pcduino/pcDuino3C_carrierboard/README.md

# pcDuino3C_carrierboard
This is the fully open source pcDuino3C carrierboard design files
