pcduino/pcDuino3C_carrierboard/pcDuino3c_carrierboard BOM.xlsx

Qty | Value | Device | Package | Parts
Connectors
1 | BTB-50PIN-0.8 | 50P socket | SMT | J3 J4 J5 J15
1 | 1x3P 2.54mm | single row header | plug | SV1
1 | 1X10P 2.54mm | single row socket | plug | JP4
1 | 1X6P 2.54mm | single row socket | plug | JP2
2 | 1X8P 2.54mm | single row socket | plug | JP1,JP3
1 | CON-BAT | CON-BAT | CON-BAT-5P-1MM | J1
1 | CON-HDMI | CON-HDMI | HDMI 19plug type A | J11
1 | CON-SATA | CON-SATA | CON-SATA | J13
1 | CON-USB | CON-USB | CON-USB | J7
1 | DCJ0202 | DCJ0202 | DCJ0202 | J2
1 | J1011F01P | network transformer | plug | X1 | unknown
1 | MINI-USB | USB socket | SMT | X2
5 | SMD_KEY | SMD_KEY | SMT | S1,S2,S3,S4,S5
1 | XH-2 2.54mm | XH-2 socket | plug | PWR
1 | FPC-30P-0.5 | FPC connector | FH12-30S-0.5SH | X3 | 1324555 | 34M6176
1 | SOCKET-MICROSD | SOCKET-MICROSD | SOCKET-MICROSD | J12
Resistors
2 | 0R | R-EU_R0402 | R0402 | R9,R21
1 | 0R | R-EU_R0805 | R0805 | R95
7 | 0R/NC | R-EU_R0402 | R0402 | R6,R80,R81,R82,R83,R85,R86,R36
4 | 100K | R-EU_R0402 | R0402 | R5,R29,R55,R87
1 | 100K/1% | R-EU_R0402 | R0402 | R1
1 | 100R | R-EU_R0402 | R0402 | R30,R34
5 | 100R/NC | R-EU_R0402 | R0402 | R66,R67,R68,R69,R70
29 | 10K | R-EU_R0402 | R0402 | R10,R12,R15,R17,R20,R24,R25,R26,R27,R28,R35,R37,R38,R39,R40,R41,R42,R54,R56,R57,R58,R59,R60,R61,R62,R71,R88,R90,R94
2 | 10k | R-EU_R0402 | R0402 | R43,R89
1 | 1K | R-EU_R0402 | R0402 | R8
5 | 2.2K | R-EU_R0402 | R0402 | R72,R73,R78,R79,R84
1 | 22K/1% | R-EU_R0402 | R0402 | R2
13 | 22R | R-EU_R0402 | R0402 | R46,R47,R48,R49,R50,R51,R52,R53,R63,R64,R91,R92,R93
1 | 33R | R-EU_R0402 | R0402 | R77
7 | 47K | R-EU_R0402 | R0402 | R3,R4,R7,R13,R19,R74,R75,R76
4 | 49.9R/1% | R-EU_R0402 | R0402 | R22,R23,R31,R32
2 | 510R | R-EU_R0402 | R0402 | R11,R45
1 | 6.2K/1% | R-EU_R0402 | R0402 | R33
2 | 4.7K | R-EU_R0402 | R0402 | R44,R65
Capacitor
27 | 100nF | C-EUC0402K | C0402 | C3,C5,C7,C12,C16,C18,C19,C21,C23,C24,C26,C28,C32,C33,C34,C35,C37,C39,C42,C44,C51,C56,C65,C66,C67,C68,C69
4 | 100nF | C-EUC0805 | C0805 | C9,C40,C49,C50
1 | 100pF | C-EUC0402K | C0402 | C48
4 | 10pF | C-EUC0402K | C0402 | C52,C53,C54,C55
1 | 10uF | C-EUC0402K | C0402 | C41
9 | 10uF | C-EUC0805 | C0805 | C2,C4,C6,C8,C22,C25,C27,C36,C38
2 | 18pF | C-EUC0402K | C0402 | C30,C31
4 | 1uF | C-EUC0402K | C0402 | C10,C14,C29,C45
3 | 1uF | C-EUC0805 | C0805 | C15,C17,C43
1 | 22nF | C-EUC0402K | C0402 | C13
1 | 22pF/NC | C-EUC0402K | C0402 | C46
1 | 22uF | C-EUC0805 | C0805 | C47
1 | 22uF/16V | C-EUC0805 | C0805 | C11
6 | 33pF | C-EUC0402K | C0402 | C57,C58,C59,C60,C61,C62
2 | 4.7uF | C-EUC0402K | C0402 | C63,C64
1 | 4.7uF | CPOL-EUCT7343 | CT7343 | C20
1 | 47pF | C-EUC0402K | C0402 | C1
Inductor, bead, crystal, fuse
1 | 2A_SMD | PTCFUSE-1206 | R1206 | F1
4 | 120R@300mA |  | R0603 | FB9,FB10,FB11,FB12,FB13
5 | 47R@500mA |  | R0603 | FB2,FB3,FB4,FB5,FB6
2 | LI0603EXXXR-10 | LI0603EXXXR-10 | R0603 | FB1,FB8
1 | 4.7uH/1.5A | INDICATORCD32 | CD32 | L1
3 | IND-CL-2M2012 | Inductor | CL-2M2012 | L2,L3,L4
1 | 25MHz | passive crystal | 3225 | Y1
1 | NC | LI0603EXXXR-10 | R0603 | FB7
Diode, transistor, MOS
1 | LED | LED-BLUE | LED-0805 | D6
1 | LED | LED-GREEN | LED-0805 | D2
2 | AO3401 | P-MOS | SOT23 | Q1,Q2
4 | MMBT3904 | NPN Transistor | SOT23 | T1,T2,T3,T4
1 | MMSZ5232B | DIODE-SMD2010 | D2010 | D5
2 | XBS104S14 | SCHOTTKY | D1206 | D7,D8
44 | ESDPSA0402V05 | ESDPSA0402V05 | R0402 | ESD1,ESD2,ESD3,ESD4,ESD5,ESD6,ESD7,ESD8,ESD9,ESD10,ESD11,ESD12,ESD13,ESD14,ESD15,ESD16,ESD17,ESD18,ESD19,ESD20,ESD21,ESD22,ESD23,ESD24,ESD25,ESD26,ESD27,ESD28,ESD29,ESD30,ESD31,ESD32,ESD33,ESD34,ESD35,ESD36,ESD37,ESD38,ESD39,ESD40,ESD41,ESD42,ESD43,ESD44
IC
1 | INFARED | INFARED | HS/VS1838 | U9
1 | IP101ALF | IP101ALF | LQFP48 | U4
1 | PJ-342B | PJ-342B | PJ-342B | J14
1 | AXK824145WG | CAM Male | 12x2P 0.4mm | J10
1 | RT9193GB | RT9193GB | SOT23-5 | U3
1 | RT9701GB | RT9701GB | SOT23-5 | U2
1 | RTL8188CUS | WIFI Mould | PCDUINO-WIFI-0_1PRIMARY | J8
3 | RCLAMP0524P | SEDFN05V4 | RCLAMP0524P | U6,U7,U8
1 | SY8088 | SY8088 | SOT23-5 | U1
