pcduino/pcDuino3C_carrierboard/pcDuino3c_carrierboard_designfiles/pcDuino3c_MB.brd

## EAGLE design pcDuino3c_carrierboard_designfiles/pcDuino3c_MB.brd (2015-03-08)

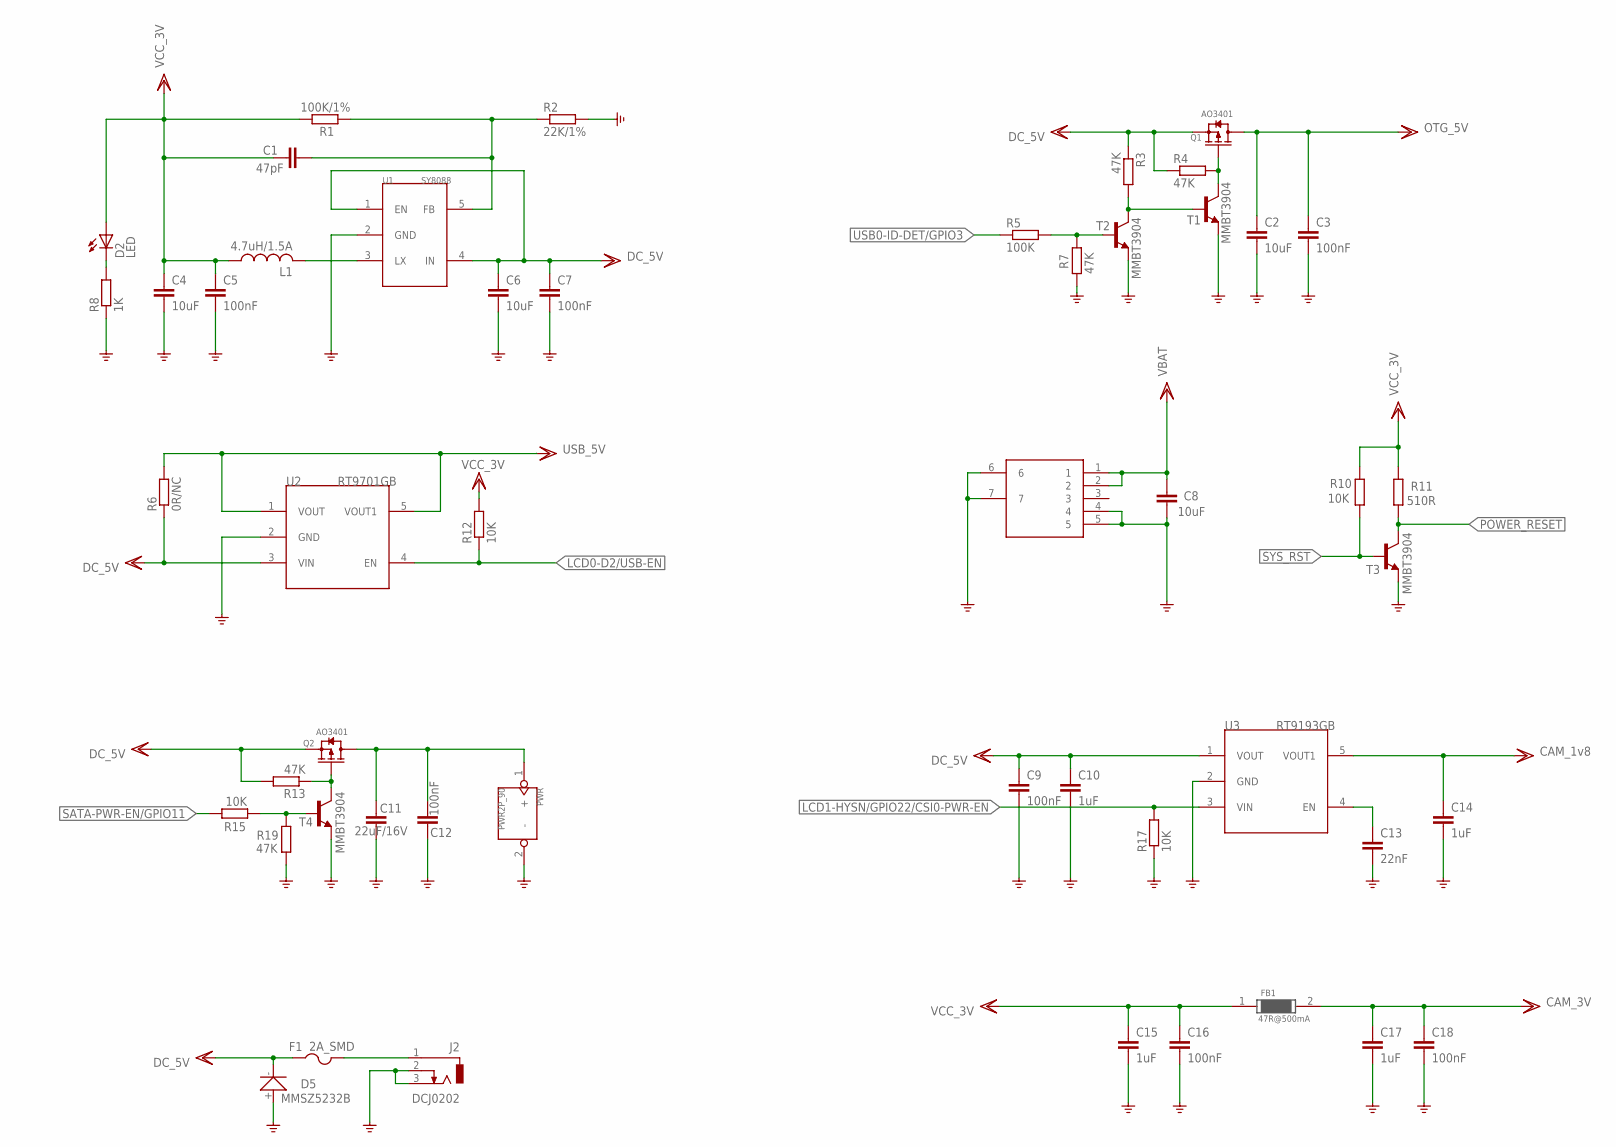
[picture p1: schematic pcDuino3c_MB.sch, sheet 1, PWR]

Parts:
C1: 47pF; C0402K
C2, C4, C6, C8: 10uF; C0805
C3, C5, C7, C12, C16, C18: 100nF; C0402K
C9: 100nF; C0805
C10, C14: 1uF; C0402K
C11: 22uF/16V; C0805
C13: 22nF; C0402K
C15, C17: 1uF; C0805
D2: LED; CHIP-LED-0805
D5: MMSZ5232B; SOD123
F1: 2A_SMD; R1206
FB1: 47R@500mA; R0603
J1: CON-BAT; CON-BAT-5P-1MM
J2: DCJ0202
L1: 4.7uH/1.5A; L_CD32
PWR: PWR2P_90; PWR2P_2.54
Q1, Q2: AO3401; SOT23
R1: 100K/1%; R0402
R2: 22K/1%; R0402
R3, R4, R7, R13, R19: 47K; R0402
R5: 100K; R0402
R6: 0R/NC; R0402
R8: 1K; R0402
R10, R12, R15, R17: 10K; R0402
R11: 510R; R0402
T1, T2, T3, T4: MMBT3904; SOT23-BEC
U1: SY8088; SOT23-5
U2: RT9701GB; SOT23-5
U3: RT9193GB; SOT23-5

Connections:
CAM_1V8: C14.1, U3.5 (VOUT1); also elsewhere on the board
CAM_3V: C17.1, C18.1, FB1.2; also elsewhere on the board
DC_5V: C6.1, C7.1, C9.1, C10.1, D5.-, F1.1, Q1.2 (S), Q2.2 (S), R3.1, R4.1, R6.1, R13.2, U1.1 (EN), U1.4 (IN), U2.3 (VIN), U3.1 (VOUT); also elsewhere on the board
GND: C2.2, C3.2, C4.2, C5.2, C6.2, C7.2, C8.2, C9.2, C10.2, C11.2, C12.2, C13.2, C14.2, C15.2, C16.2, C17.2, C18.2, D5.+, J1.4, J1.5, J1.6, J1.7, J2.2, J2.3, PWR.2 (-), R2.2, R7.1, R8.1, R17.1, R19.1, T1.E, T2.E, T3.E, T4.E, U1.2 (GND), U2.2 (GND), U3.2 (GND); also elsewhere on the board
LCD0-D2/USB-EN: R12.1, U2.4 (EN); also elsewhere on the board
LCD1-HYSN/GPIO22/CSI0-PWR-EN: R17.2, U3.3 (VIN)
unnamed: C13.1, U3.4 (EN)
unnamed: L1.2, U1.3 (LX)
unnamed: C1.2, R1.1, R2.1, U1.5 (FB)
unnamed: D2.C, R8.2
unnamed: Q1.1 (G), R4.2, T1.C
unnamed: R3.2, T1.B, T2.C
unnamed: R5.2, R7.2, T2.B
unnamed: C11.1, C12.1, PWR.1 (+), Q2.3 (D)
unnamed: F1.2, J2.1
unnamed: Q2.1 (G), R13.1, T4.C
unnamed: R15.1, R19.2, T4.B
OTG_5V: C2.1, C3.1, Q1.3 (D); also elsewhere on the board
POWER_RESET: R11.1, T3.C; also elsewhere on the board
SATA-PWR-EN/GPIO11: R15.2; also elsewhere on the board
SYS_RST: R10.1, T3.B; also elsewhere on the board
USB0-ID-DET/GPIO3: R5.1; also elsewhere on the board
USB_5V: R6.2, U2.1 (VOUT), U2.5 (VOUT1); also elsewhere on the board
VBAT: C8.1, J1.1, J1.2; also elsewhere on the board
VCC_3V: C1.1, C4.1, C5.1, C15.1, C16.1, D2.A, FB1.1, L1.1, R1.2, R10.2, R11.2, R12.2; also elsewhere on the board

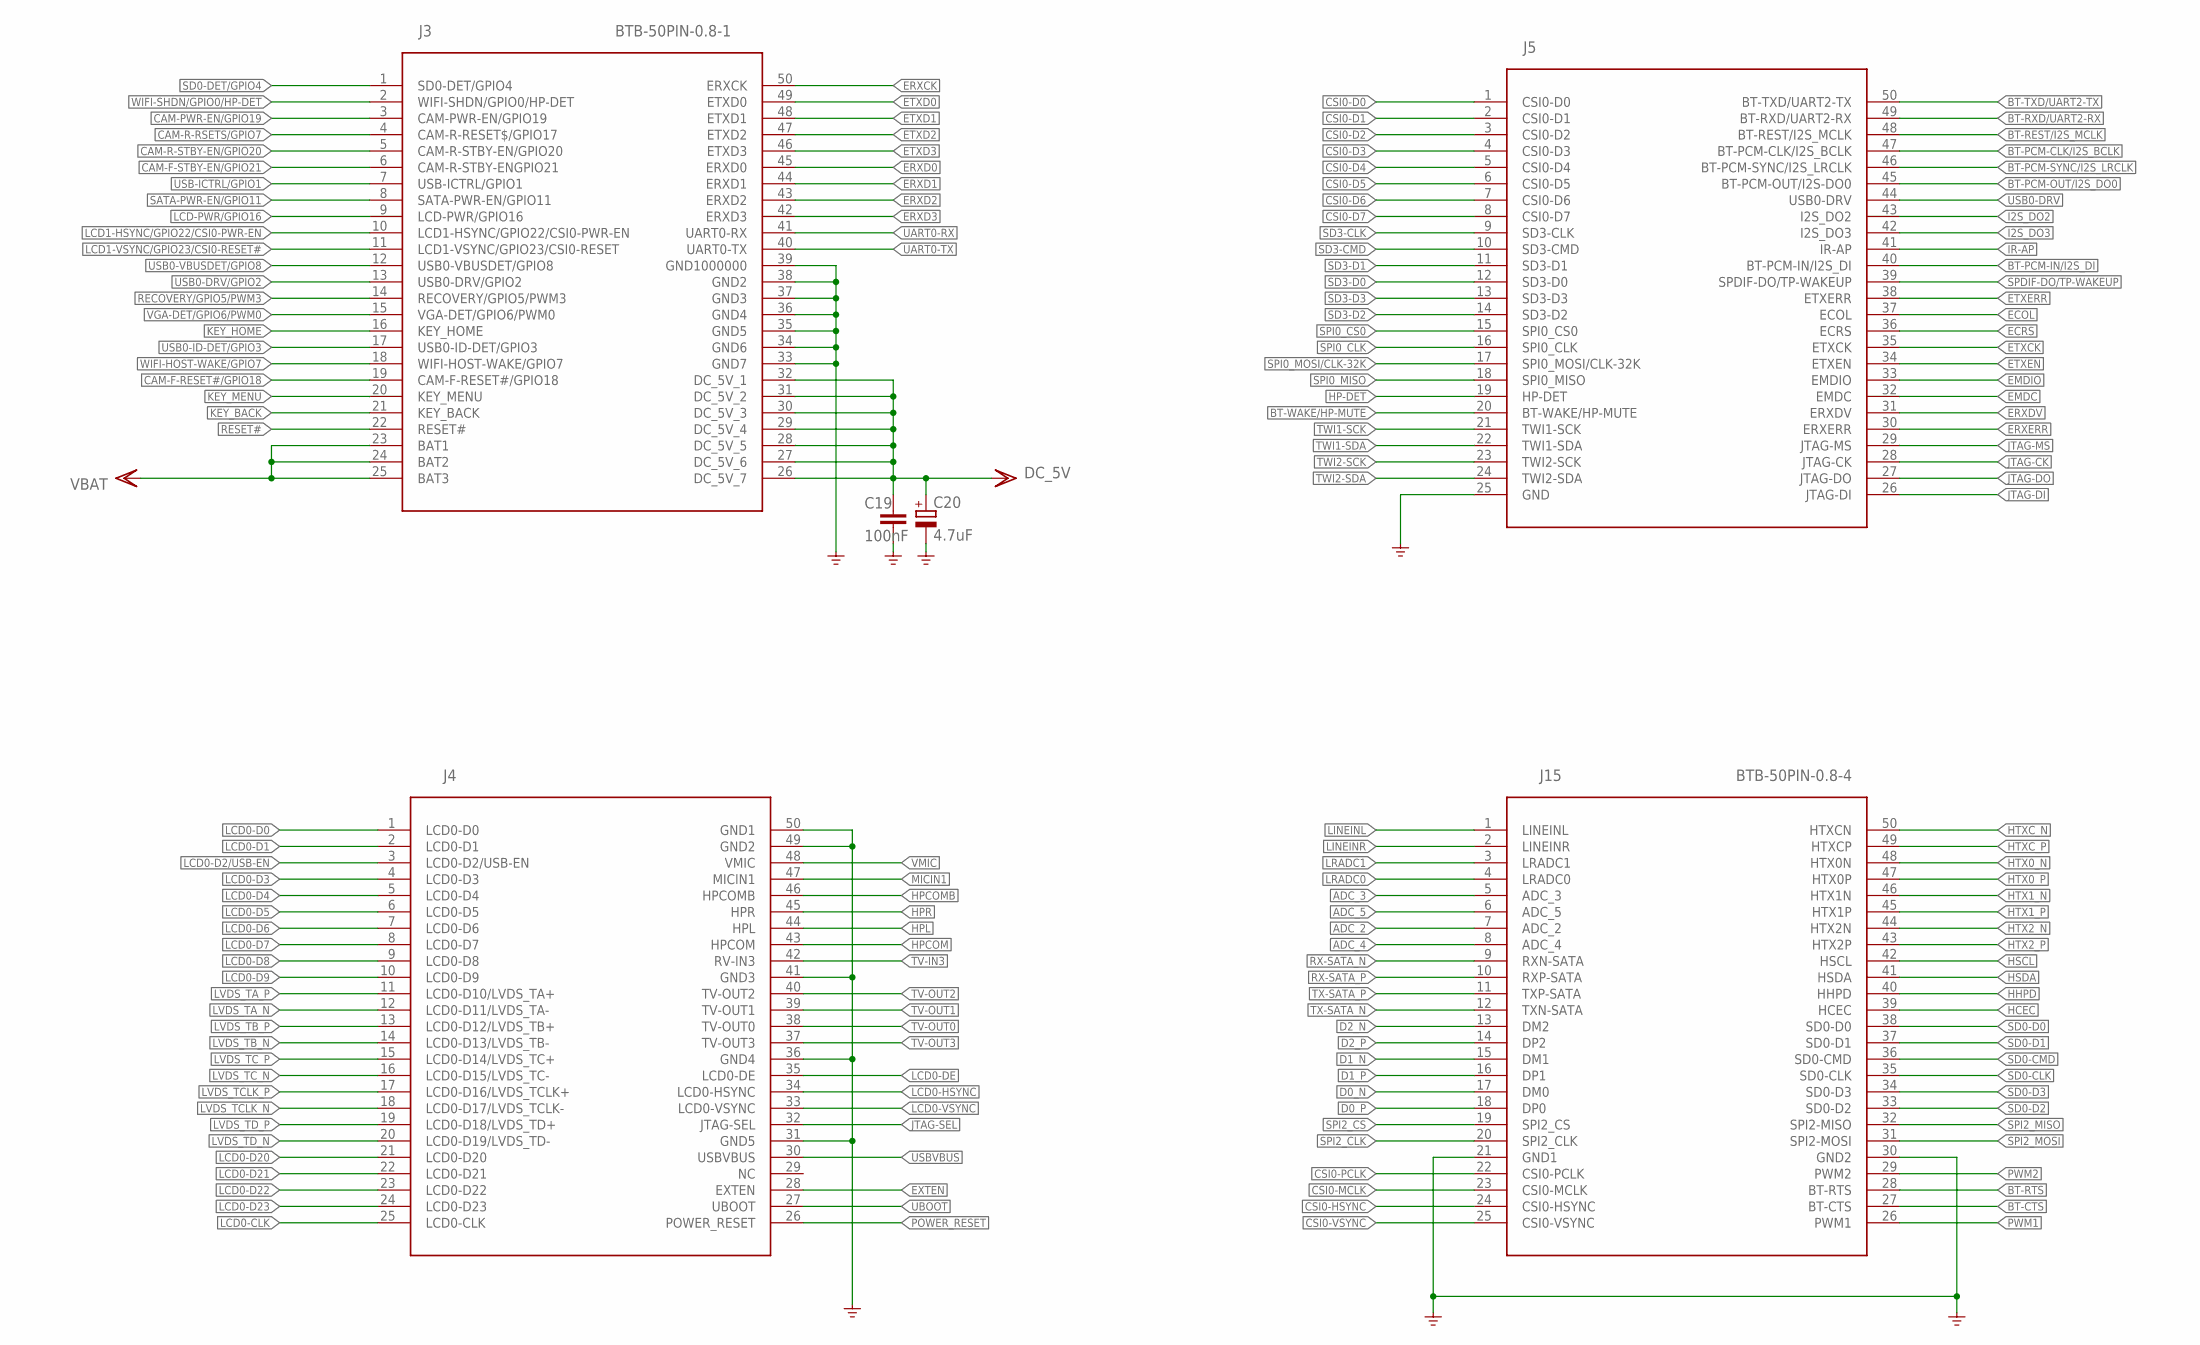
[picture p2: schematic pcDuino3c_MB.sch, sheet 2, A20 Core]

Parts:
C19: 100nF; C0402K
C20: 4.7uF; CT7343
J3: BTB-50PIN-0.8-1; BTB-50PIN-0.8
J4: BTB-50PIN-0.8-3; BTB-50PIN-0.8
J5: BTB-50PIN-0.8-2; BTB-50PIN-0.8
J15: BTB-50PIN-0.8-4; BTB-50PIN-0.8

Connections:
ADC_2: J15.7 (ADC_2); also elsewhere on the board
ADC_3: J15.5 (ADC_3); also elsewhere on the board
ADC_4: J15.8 (ADC_4); also elsewhere on the board
ADC_5: J15.6 (ADC_5); also elsewhere on the board
BT-CTS: J15.27 (BT-CTS)
BT-PCM-CLK/I2S_BCLK: J5.47 (BT-PCM-CLK/I2S_BCLK)
BT-PCM-IN/I2S_DI: J5.40 (BT-PCM-IN/I2S_DI)
BT-PCM-OUT/I2S_DO0: J5.45 (BT-PCM-OUT/I2S-DO0)
BT-PCM-SYNC/I2S_LRCLK: J5.46 (BT-PCM-SYNC/I2S_LRCLK)
BT-REST/I2S_MCLK: J5.48 (BT-REST/I2S_MCLK)
BT-RTS: J15.28 (BT-RTS)
BT-RXD/UART2-RX: J5.49 (BT-RXD/UART2-RX); also elsewhere on the board
BT-TXD/UART2-TX: J5.50 (BT-TXD/UART2-TX); also elsewhere on the board
BT-WAKE/HP-MUTE: J5.20 (BT-WAKE/HP-MUTE)
CAM-F-RESET#/GPIO18: J3.19 (CAM-F-RESET#/GPIO18); also elsewhere on the board
CAM-F-STBY-EN/GPIO21: J3.6 (CAM-R-STBY-ENGPIO21); also elsewhere on the board
CAM-PWR-EN/GPIO19: J3.3 (CAM-PWR-EN/GPIO19); also elsewhere on the board
CAM-R-RSETS/GPIO7: J3.4 (CAM-R-RESET$/GPIO17)
CAM-R-STBY-EN/GPIO20: J3.5 (CAM-R-STBY-EN/GPIO20); also elsewhere on the board
CSI0-D0: J5.1 (CSI0-D0); also elsewhere on the board
CSI0-D1: J5.2 (CSI0-D1); also elsewhere on the board
CSI0-D2: J5.3 (CSI0-D2); also elsewhere on the board
CSI0-D3: J5.4 (CSI0-D3); also elsewhere on the board
CSI0-D4: J5.5 (CSI0-D4); also elsewhere on the board
CSI0-D5: J5.6 (CSI0-D5); also elsewhere on the board
CSI0-D6: J5.7 (CSI0-D6); also elsewhere on the board
CSI0-D7: J5.8 (CSI0-D7); also elsewhere on the board
CSI0-HSYNC: J15.24 (CSI0-HSYNC); also elsewhere on the board
CSI0-MCLK: J15.23 (CSI0-MCLK); also elsewhere on the board
CSI0-PCLK: J15.22 (CSI0-PCLK); also elsewhere on the board
CSI0-VSYNC: J15.25 (CSI0-VSYNC); also elsewhere on the board
D0_N: J15.17 (DM0); also elsewhere on the board
D0_P: J15.18 (DP0); also elsewhere on the board
D1_N: J15.15 (DM1); also elsewhere on the board
D1_P: J15.16 (DP1); also elsewhere on the board
D2_N: J15.13 (DM2); also elsewhere on the board
D2_P: J15.14 (DP2); also elsewhere on the board
DC_5V: C19.1, C20.+, J3.26 (DC_5V_7), J3.27 (DC_5V_6), J3.28 (DC_5V_5), J3.29 (DC_5V_4), J3.30 (DC_5V_3), J3.31 (DC_5V_2), J3.32 (DC_5V_1); also elsewhere on the board
ECOL: J5.37 (ECOL); also elsewhere on the board
ECRS: J5.36 (ECRS); also elsewhere on the board
EMDC: J5.32 (EMDC); also elsewhere on the board
EMDIO: J5.33 (EMDIO); also elsewhere on the board
ERXCK: J3.50 (ERXCK); also elsewhere on the board
ERXD0: J3.45 (ERXD0); also elsewhere on the board
ERXD1: J3.44 (ERXD1); also elsewhere on the board
ERXD2: J3.43 (ERXD2); also elsewhere on the board
ERXD3: J3.42 (ERXD3); also elsewhere on the board
ERXDV: J5.31 (ERXDV); also elsewhere on the board
ERXERR: J5.30 (ERXERR); also elsewhere on the board
ETXCK: J5.35 (ETXCK); also elsewhere on the board
ETXD0: J3.49 (ETXD0); also elsewhere on the board
ETXD1: J3.48 (ETXD1); also elsewhere on the board
ETXD2: J3.47 (ETXD2); also elsewhere on the board
ETXD3: J3.46 (ETXD3); also elsewhere on the board
ETXEN: J5.34 (ETXEN); also elsewhere on the board
ETXERR: J5.38 (ETXERR); also elsewhere on the board
EXTEN: J4.28 (EXTEN)
GND: C19.2, C20.-, J3.33 (GND7), J3.34 (GND6), J3.35 (GND5), J3.36 (GND4), J3.37 (GND3), J3.38 (GND2), J3.39 (GND1000000), J4.31 (GND5), J4.36 (GND4), J4.41 (GND3), J4.49 (GND2), J4.50 (GND1), J5.25 (GND), J15.21 (GND1), J15.30 (GND2); also elsewhere on the board
HCEC: J15.39 (HCEC); also elsewhere on the board
HHPD: J15.40 (HHPD); also elsewhere on the board
HP-DET: J5.19 (HP-DET)
HPCOM: J4.43 (HPCOM); also elsewhere on the board
HPCOMB: J4.46 (HPCOMB); also elsewhere on the board
HPL: J4.44 (HPL); also elsewhere on the board
HPR: J4.45 (HPR); also elsewhere on the board
HSCL: J15.42 (HSCL); also elsewhere on the board
HSDA: J15.41 (HSDA); also elsewhere on the board
HTX0_N: J15.48 (HTX0N); also elsewhere on the board
HTX0_P: J15.47 (HTX0P); also elsewhere on the board
HTX1_N: J15.46 (HTX1N); also elsewhere on the board
HTX1_P: J15.45 (HTX1P); also elsewhere on the board
HTX2_N: J15.44 (HTX2N); also elsewhere on the board
HTX2_P: J15.43 (HTX2P); also elsewhere on the board
HTXC_N: J15.50 (HTXCN); also elsewhere on the board
HTXC_P: J15.49 (HTXCP); also elsewhere on the board
I2S_DO2: J5.43 (I2S_DO2)
I2S_DO3: J5.42 (I2S_DO3)
IR-AP: J5.41 (IR-AP); also elsewhere on the board
JTAG-CK: J5.28 (JTAG-CK)
JTAG-DI: J5.26 (JTAG-DI)
JTAG-DO: J5.27 (JTAG-DO)
JTAG-MS: J5.29 (JTAG-MS)
JTAG-SEL: J4.32 (JTAG-SEL)
KEY_BACK: J3.21 (KEY_BACK); also elsewhere on the board
KEY_HOME: J3.16 (KEY_HOME); also elsewhere on the board
KEY_MENU: J3.20 (KEY_MENU); also elsewhere on the board
LCD0-CLK: J4.25 (LCD0-CLK)
LCD0-D0: J4.1 (LCD0-D0)
LCD0-D1: J4.2 (LCD0-D1)
LCD0-D2/USB-EN: J4.3 (LCD0-D2/USB-EN); also elsewhere on the board
LCD0-D3: J4.4 (LCD0-D3)
LCD0-D4: J4.5 (LCD0-D4)
LCD0-D5: J4.6 (LCD0-D5)
LCD0-D6: J4.7 (LCD0-D6)
LCD0-D7: J4.8 (LCD0-D7)
LCD0-D8: J4.9 (LCD0-D8)
LCD0-D9: J4.10 (LCD0-D9)
LCD0-D20: J4.21 (LCD0-D20)
LCD0-D21: J4.22 (LCD0-D21)
LCD0-D22: J4.23 (LCD0-D22)
LCD0-D23: J4.24 (LCD0-D23)
LCD0-DE: J4.35 (LCD0-DE)
LCD0-HSYNC: J4.34 (LCD0-HSYNC)
LCD0-VSYNC: J4.33 (LCD0-VSYNC)
LCD1-HSYNC/GPIO22/CSI0-PWR-EN: J3.10 (LCD1-HSYNC/GPIO22/CSI0-PWR-EN); also elsewhere on the board
LCD1-VSYNC/GPIO23/CSI0-RESET#: J3.11 (LCD1-VSYNC/GPIO23/CSI0-RESET); also elsewhere on the board
LCD-PWR/GPIO16: J3.9 (LCD-PWR/GPIO16)
LINEINL: J15.1 (LINEINL)
LINEINR: J15.2 (LINEINR)
LRADC0: J15.4 (LRADC0); also elsewhere on the board
LRADC1: J15.3 (LRADC1); also elsewhere on the board
LVDS_TA_N: J4.12 (LCD0-D11/LVDS_TA-); also elsewhere on the board
LVDS_TA_P: J4.11 (LCD0-D10/LVDS_TA+); also elsewhere on the board
LVDS_TB_N: J4.14 (LCD0-D13/LVDS_TB-); also elsewhere on the board
LVDS_TB_P: J4.13 (LCD0-D12/LVDS_TB+); also elsewhere on the board
LVDS_TCLK_N: J4.18 (LCD0-D17/LVDS_TCLK-); also elsewhere on the board
LVDS_TCLK_P: J4.17 (LCD0-D16/LVDS_TCLK+); also elsewhere on the board
LVDS_TC_N: J4.16 (LCD0-D15/LVDS_TC-); also elsewhere on the board
LVDS_TC_P: J4.15 (LCD0-D14/LVDS_TC+); also elsewhere on the board
LVDS_TD_N: J4.20 (LCD0-D19/LVDS_TD-); also elsewhere on the board
LVDS_TD_P: J4.19 (LCD0-D18/LVDS_TD+); also elsewhere on the board
MICIN1: J4.47 (MICIN1); also elsewhere on the board
POWER_RESET: J4.26 (POWER_RESET); also elsewhere on the board
PWM1: J15.26 (PWM1); also elsewhere on the board
PWM2: J15.29 (PWM2); also elsewhere on the board
RECOVERY/GPIO5/PWM3: J3.14 (RECOVERY/GPIO5/PWM3); also elsewhere on the board
RESET#: J3.22 (RESET#)
RX-SATA_N: J15.9 (RXN-SATA); also elsewhere on the board
RX-SATA_P: J15.10 (RXP-SATA); also elsewhere on the board
SATA-PWR-EN/GPIO11: J3.8 (SATA-PWR-EN/GPIO11); also elsewhere on the board
SD0-CLK: J15.35 (SD0-CLK); also elsewhere on the board
SD0-CMD: J15.36 (SD0-CMD); also elsewhere on the board
SD0-D0: J15.38 (SD0-D0); also elsewhere on the board
SD0-D1: J15.37 (SD0-D1); also elsewhere on the board
SD0-D2: J15.33 (SD0-D2); also elsewhere on the board
SD0-D3: J15.34 (SD0-D3); also elsewhere on the board
SD0-DET/GPIO4: J3.1 (SD0-DET/GPIO4); also elsewhere on the board
SD3-CLK: J5.9 (SD3-CLK)
SD3-CMD: J5.10 (SD3-CMD)
SD3-D0: J5.12 (SD3-D0)
SD3-D1: J5.11 (SD3-D1)
SD3-D2: J5.14 (SD3-D2)
SD3-D3: J5.13 (SD3-D3)
SPDIF-DO/TP-WAKEUP: J5.39 (SPDIF-DO/TP-WAKEUP)
SPI0_CLK: J5.16 (SPI0_CLK); also elsewhere on the board
SPI0_CS0: J5.15 (SPI0_CS0); also elsewhere on the board
SPI0_MISO: J5.18 (SPI0_MISO); also elsewhere on the board
SPI0_MOSI/CLK-32K: J5.17 (SPI0_MOSI/CLK-32K); also elsewhere on the board
SPI2_CLK: J15.20 (SPI2_CLK)
SPI2_CS: J15.19 (SPI2_CS)
SPI2_MISO: J15.32 (SPI2-MISO)
SPI2_MOSI: J15.31 (SPI2-MOSI)
TV-IN3: J4.42 (RV-IN3)
TV-OUT0: J4.38 (TV-OUT0)
TV-OUT1: J4.39 (TV-OUT1)
TV-OUT2: J4.40 (TV-OUT2)
TV-OUT3: J4.37 (TV-OUT3)
TWI1-SCK: J5.21 (TWI1-SCK); also elsewhere on the board
TWI1-SDA: J5.22 (TWI1-SDA); also elsewhere on the board
TWI2-SCK: J5.23 (TWI2-SCK); also elsewhere on the board
TWI2-SDA: J5.24 (TWI2-SDA); also elsewhere on the board
TX-SATA_N: J15.12 (TXN-SATA); also elsewhere on the board
TX-SATA_P: J15.11 (TXP-SATA); also elsewhere on the board
UART0-RX: J3.41 (UART0-RX); also elsewhere on the board
UART0-TX: J3.40 (UART0-TX); also elsewhere on the board
UBOOT: J4.27 (UBOOT); also elsewhere on the board
USB0-DRV: J5.44 (USB0-DRV)
USB0-DRV/GPIO2: J3.13 (USB0-DRV/GPIO2); also elsewhere on the board
USB0-ID-DET/GPIO3: J3.17 (USB0-ID-DET/GPIO3); also elsewhere on the board
USB0-VBUSDET/GPIO8: J3.12 (USB0-VBUSDET/GPIO8); also elsewhere on the board
USB-ICTRL/GPIO1: J3.7 (USB-ICTRL/GPIO1); also elsewhere on the board
USBVBUS: J4.30 (USBVBUS)
VBAT: J3.23 (BAT1), J3.24 (BAT2), J3.25 (BAT3); also elsewhere on the board
VGA-DET/GPIO6/PWM0: J3.15 (VGA-DET/GPIO6/PWM0); also elsewhere on the board
VMIC: J4.48 (VMIC); also elsewhere on the board
WIFI-HOST-WAKE/GPIO7: J3.18 (WIFI-HOST-WAKE/GPIO7); also elsewhere on the board
WIFI-SHDN/GPIO0/HP-DET: J3.2 (WIFI-SHDN/GPIO0/HP-DET); also elsewhere on the board

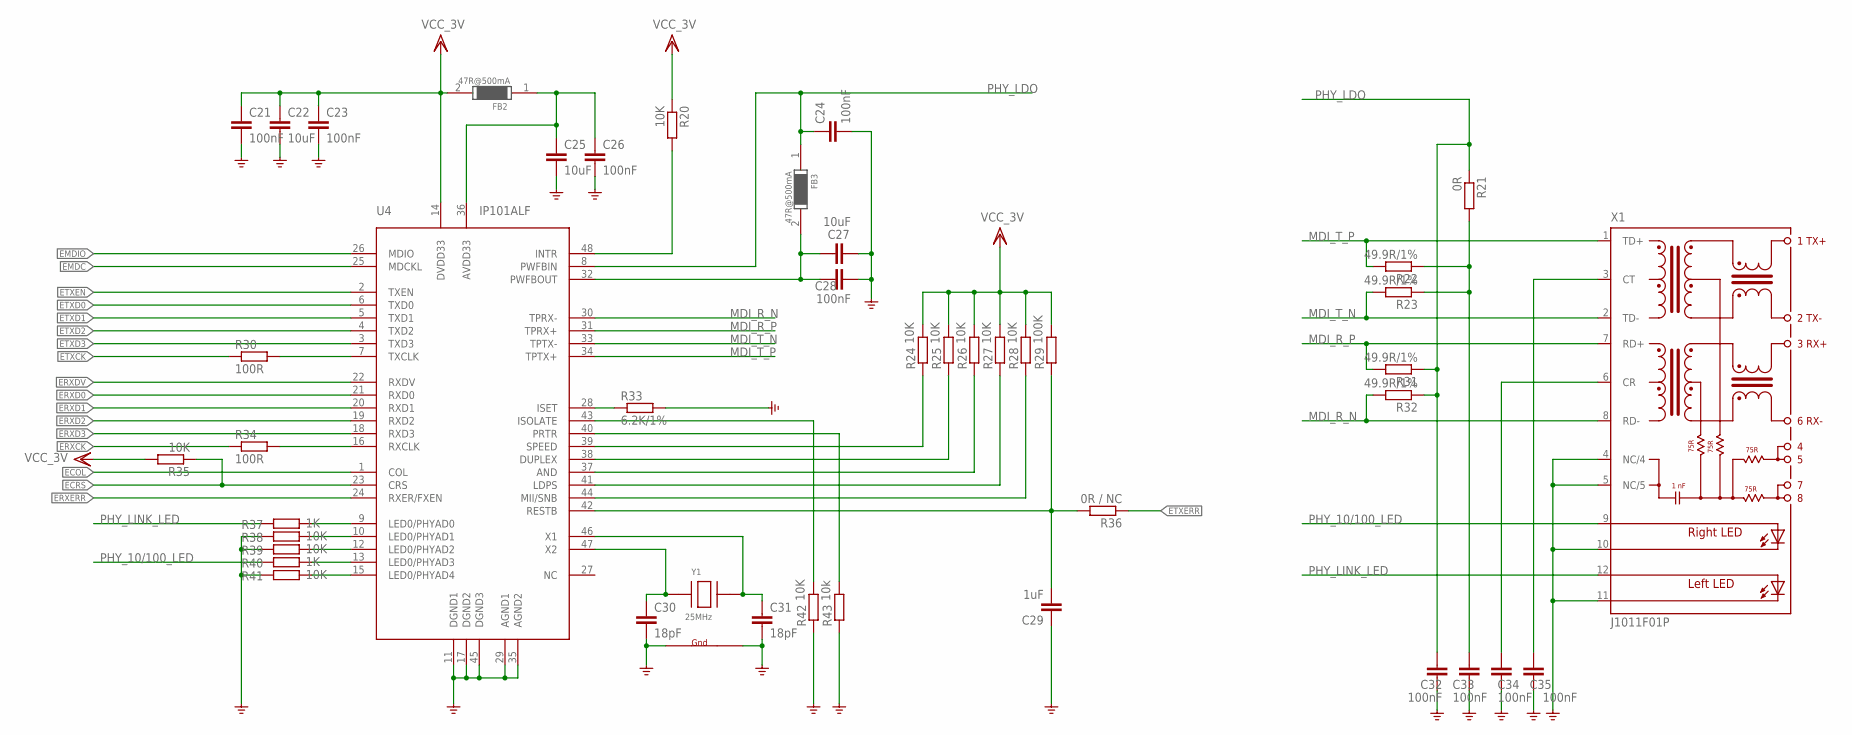
[picture p3: schematic pcDuino3c_MB.sch, sheet 3, EMAC]

Parts:
C21, C23, C24, C26, C28, C32, C33, C34, C35: 100nF; C0402K
C22, C25, C27: 10uF; C0805
C29: 1uF; C0402K
C30, C31: 18pF; C0402K
FB2, FB3: 47R@500mA; R0603
R20, R24, R25, R26, R27, R28, R35, R38, R39, R41, R42: 10K; R0402
R21: 0R; R0402
R22, R23, R31, R32: 49.9R/1%; R0402
R29: 100K; R0402
R30, R34: 100R; R0402
R33: 6.2K/1%; R0402
R36: 0R / NC; R0402
R37, R40: 1K; R0402
R43: 10k; R0402
U4: IP101ALF; LQFP48-7X7
X1: J1011F01P; J1
Y1: 25MHz; NX3225

Connections:
ECOL: U4.1 (COL); also elsewhere on the board
ECRS: R35.1, U4.23 (CRS); also elsewhere on the board
EMDC: U4.25 (MDCKL); also elsewhere on the board
EMDIO: U4.26 (MDIO); also elsewhere on the board
ERXCK: R34.1; also elsewhere on the board
ERXD0: U4.21 (RXD0); also elsewhere on the board
ERXD1: U4.20 (RXD1); also elsewhere on the board
ERXD2: U4.19 (RXD2); also elsewhere on the board
ERXD3: U4.18 (RXD3); also elsewhere on the board
ERXDV: U4.22 (RXDV); also elsewhere on the board
ERXERR: U4.24 (RXER/FXEN); also elsewhere on the board
ETXCK: R30.1; also elsewhere on the board
ETXD0: U4.6 (TXD0); also elsewhere on the board
ETXD1: U4.5 (TXD1); also elsewhere on the board
ETXD2: U4.4 (TXD2); also elsewhere on the board
ETXD3: U4.3 (TXD3); also elsewhere on the board
ETXEN: U4.2 (TXEN); also elsewhere on the board
ETXERR: R36.1; also elsewhere on the board
GND: C21.2, C22.2, C23.2, C24.2, C25.2, C26.2, C27.1, C28.2, C29.1, C30.2, C31.2, C32.1, C33.1, C34.1, C35.1, R33.2, R38.1, R39.1, R41.1, R42.1, R43.1, U4.11 (DGND1), U4.17 (DGND2), U4.29 (AGND1), U4.35 (AGND2), U4.45 (DGND3), X1.4 (NC/4), X1.5 (NC/5), X1.10 (C-R), X1.11 (C-L), Y1.2 (G1), Y1.4 (G2); also elsewhere on the board
MDI_R_N: R32.2, U4.30 (TPRX-), X1.8 (RD-)
MDI_R_P: R31.2, U4.31 (TPRX+), X1.7 (RD+)
MDI_T_N: R23.2, U4.33 (TPTX-), X1.2 (TD-)
MDI_T_P: R22.2, U4.34 (TPTX+), X1.1 (TD+)
unnamed: C25.1, C26.1, FB2.1, U4.36 (AVDD33)
unnamed: C34.2, X1.6 (CR)
unnamed: C35.2, X1.3 (CT)
unnamed: C33.2, R21.2, R22.1, R23.1
unnamed: R20.2, U4.48 (INTR)
unnamed: C27.2, C28.1, FB3.2, U4.32 (PWFBOUT)
unnamed: R33.1, U4.28 (ISET)
unnamed: R37.2, U4.9 (LED0/PHYAD0)
unnamed: R38.2, U4.10 (LED0/PHYAD1)
unnamed: R39.2, U4.12 (LED0/PHYAD2)
unnamed: R40.2, U4.13 (LED0/PHYAD3)
unnamed: R41.2, U4.15 (LED0/PHYAD4)
unnamed: C30.1, U4.47 (X2), Y1.1 (X1)
unnamed: R34.2, U4.16 (RXCLK)
unnamed: R30.2, U4.7 (TXCLK)
unnamed: C31.1, U4.46 (X1), Y1.3 (X2)
unnamed: R27.1, U4.41 (LDPS)
unnamed: R42.2, U4.43 (ISOLATE)
unnamed: R43.2, U4.40 (PRTR)
unnamed: R24.1, U4.39 (SPEED)
unnamed: R25.1, U4.38 (DUPLEX)
unnamed: R26.1, U4.37 (AND)
unnamed: R28.1, U4.44 (MII/SNB)
unnamed: C29.2, R29.1, R36.2, U4.42 (RESTB)
PHY_10/100_LED: R40.1, X1.9 (A-R)
PHY_LDO: C24.1, C32.2, FB3.1, R21.1, R31.1, R32.1, U4.8 (PWFBIN)
PHY_LINK_LED: R37.1, X1.12 (AL)
VCC_3V: C21.1, C22.1, C23.1, FB2.2, R20.1, R24.2, R25.2, R26.2, R27.2, R28.2, R29.2, R35.2, U4.14 (DVDD33); also elsewhere on the board

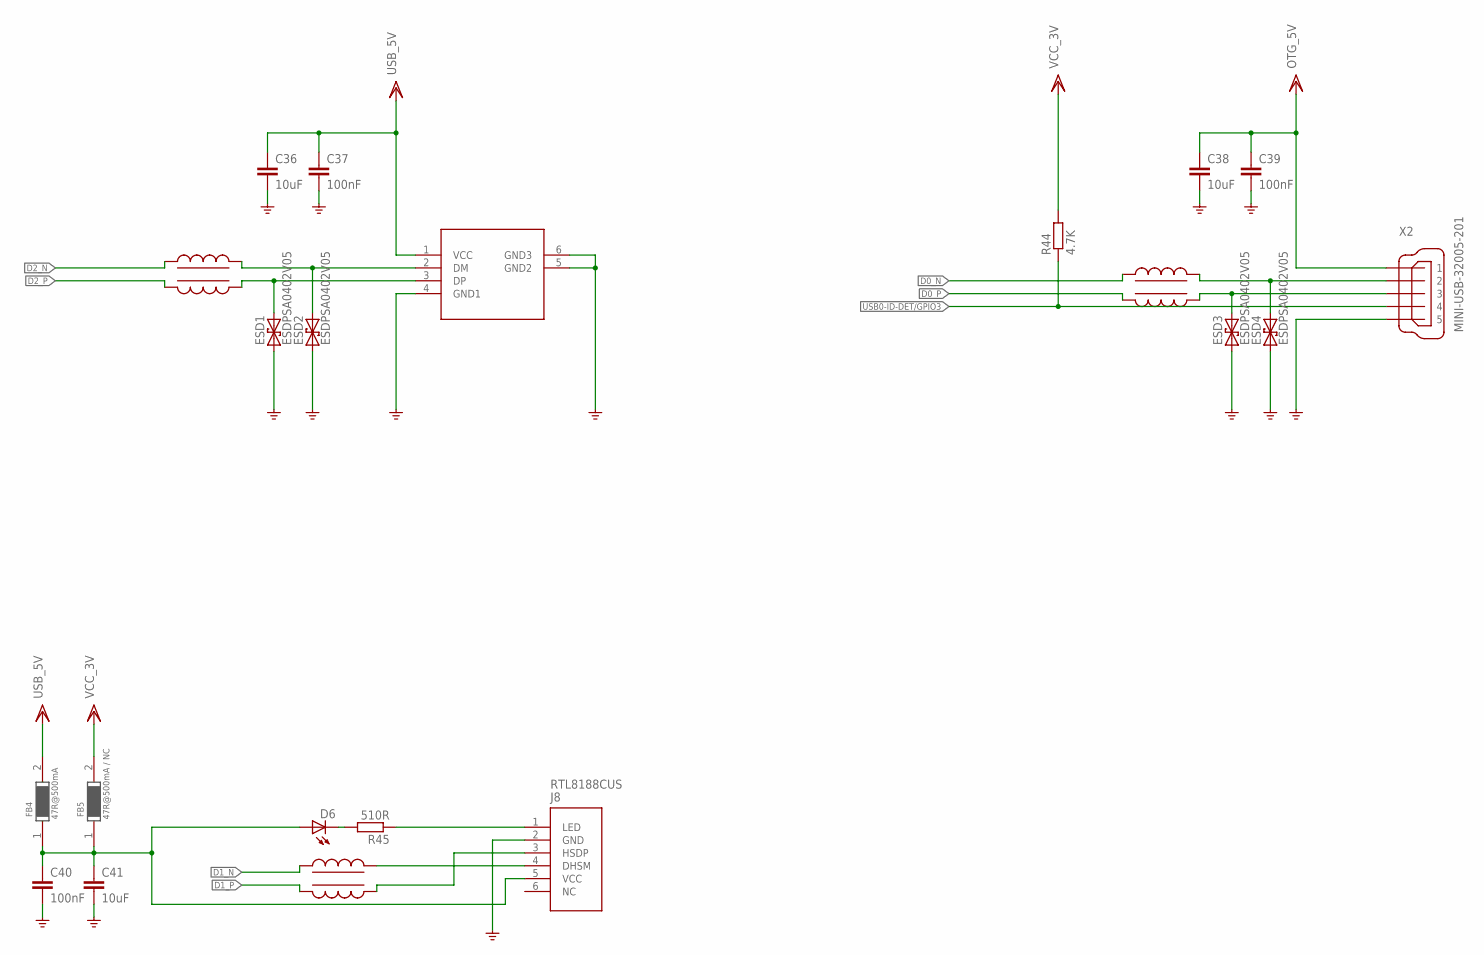
[picture p4: schematic pcDuino3c_MB.sch, sheet 4, USB]

Parts:
C36, C38: 10uF; C0805
C37, C39: 100nF; C0402K
C40: 100nF; C0805
C41: 10uF; C0402K
D6: LED; CHIP-LED-0805
ESD1, ESD2, ESD3, ESD4: ESDPSA0402V05; R0402
FB4: 47R@500mA; R0603
FB5: 47R@500mA / NC; R0603
J7: CON-USB
J8: RTL8188CUS; PCDUINO-WIFI-0_1PRIMARY
L2, L3, L4: IND-CL-2M2012; CL-2M2012
R44: 4.7K; R0402
R45: 510R; R0402
X2: MINI-USB-32005-201; 32005-201

Connections:
D0_N: L3.1; also elsewhere on the board
D0_P: L3.2; also elsewhere on the board
D1_N: L4.1; also elsewhere on the board
D1_P: L4.2; also elsewhere on the board
D2_N: L2.1; also elsewhere on the board
D2_P: L2.2; also elsewhere on the board
GND: C36.2, C37.2, C38.2, C39.2, C40.2, C41.2, ESD1.1, ESD2.1, ESD3.1, ESD4.1, J7.4 (GND1), J7.5 (GND2), J7.6 (GND3), J8.2 (GND), X2.5; also elsewhere on the board
unnamed: J8.4 (DHSM), L4.4
unnamed: J8.1 (LED), R45.1
unnamed: J8.3 (HSDP), L4.3
unnamed: D6.C, R45.2
unnamed: ESD2.2, J7.2 (DM), L2.4
unnamed: ESD1.2, J7.3 (DP), L2.3
unnamed: ESD4.2, L3.4, X2.2
unnamed: C40.1, C41.1, D6.A, FB4.1, FB5.1, J8.5 (VCC)
unnamed: ESD3.2, L3.3, X2.3
OTG_5V: C38.1, C39.1, X2.1; also elsewhere on the board
USB0-ID-DET/GPIO3: R44.1, X2.4; also elsewhere on the board
USB_5V: C36.1, C37.1, FB4.2, J7.1 (VCC); also elsewhere on the board
VCC_3V: FB5.2, R44.2; also elsewhere on the board

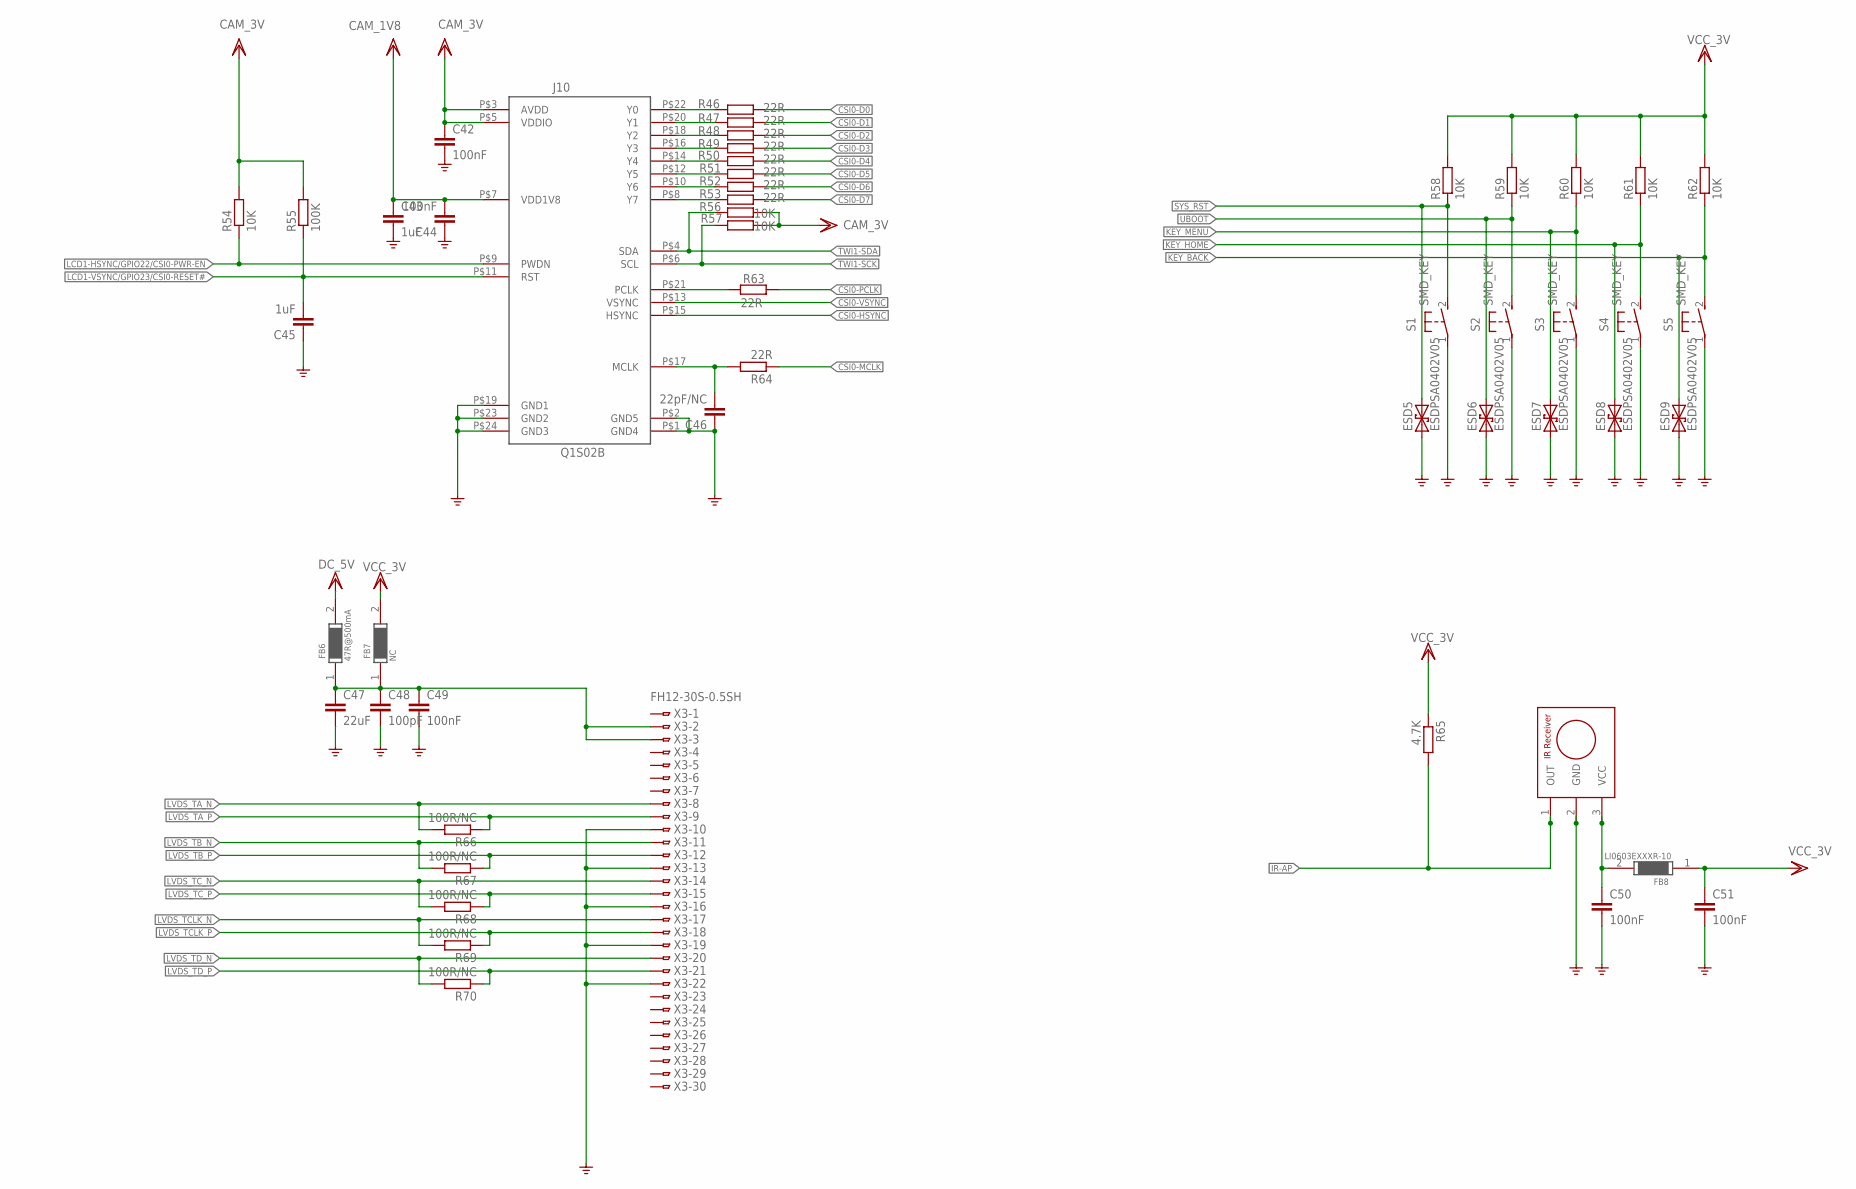
[picture p5: schematic pcDuino3c_MB.sch, sheet 5, CAM & KEY & LVDS & IR]

Parts:
C42, C44, C51: 100nF; C0402K
C43: 1uF; C0805
C45: 1uF; C0402K
C46: 22pF/NC; C0402K
C47: 22uF; C0805
C48: 100pF; C0402K
C49, C50: 100nF; C0805
ESD5, ESD6, ESD7, ESD8, ESD9: ESDPSA0402V05; R0402
FB6: 47R@500mA; R0603
FB7: NC; R0603
FB8: LI0603EXXXR-10; R0603
J10: Q1S02B; AXK824145WG
R46, R47, R48, R49, R50, R51, R52, R53, R63, R64: 22R; R0402
R54, R56, R57, R58, R59, R60, R61, R62: 10K; R0402
R55: 100K; R0402
R65: 4.7K; R0402
R66, R67, R68, R69, R70: 100R/NC; R0402
S1, S2, S3, S4, S5: SMD_KEY; KEY
U9: INFARED; HS/VS1838
X3: FH12-30S-0.5SH

Connections:
CAM_1V8: C43.1, C44.2, J10.P$7 (VDD1V8); also elsewhere on the board
CAM_3V: C42.1, J10.P$3 (AVDD), J10.P$5 (VDDIO), R54.2, R55.2, R56.1, R57.1; also elsewhere on the board
CSI0-D0: R46.1; also elsewhere on the board
CSI0-D1: R47.1; also elsewhere on the board
CSI0-D2: R48.1; also elsewhere on the board
CSI0-D3: R49.1; also elsewhere on the board
CSI0-D4: R50.1; also elsewhere on the board
CSI0-D5: R51.1; also elsewhere on the board
CSI0-D6: R52.1; also elsewhere on the board
CSI0-D7: R53.1; also elsewhere on the board
CSI0-HSYNC: J10.P$15 (HSYNC); also elsewhere on the board
CSI0-MCLK: R64.1; also elsewhere on the board
CSI0-PCLK: R63.1; also elsewhere on the board
CSI0-VSYNC: J10.P$13 (VSYNC); also elsewhere on the board
DC_5V: FB6.2; also elsewhere on the board
GND: C42.2, C43.2, C44.1, C45.1, C46.1, C47.2, C48.2, C49.2, C50.2, C51.2, ESD5.1, ESD6.1, ESD7.1, ESD8.1, ESD9.1, J10.P$1 (GND4), J10.P$2 (GND5), J10.P$19 (GND1), J10.P$23 (GND2), J10.P$24 (GND3), S1.1, S2.1, S3.1, S4.1, S5.1, U9.2 (GND), X3.9, X3.12, X3.15, X3.18, X3.21; also elsewhere on the board
IR-AP: R65.2, U9.1 (OUT); also elsewhere on the board
KEY_BACK: ESD9.2, R62.1, S5.2 (S); also elsewhere on the board
KEY_HOME: ESD8.2, R61.1, S4.2 (S); also elsewhere on the board
KEY_MENU: ESD7.2, R60.1, S3.2 (S); also elsewhere on the board
LCD1-HSYNC/GPIO22/CSI0-PWR-EN: J10.P$9 (PWDN), R54.1; also elsewhere on the board
LCD1-VSYNC/GPIO23/CSI0-RESET#: C45.2, J10.P$11 (RST), R55.1; also elsewhere on the board
LVDS_TA_N: R66.2, X3.23; also elsewhere on the board
LVDS_TA_P: R66.1, X3.22; also elsewhere on the board
LVDS_TB_N: R67.2, X3.20; also elsewhere on the board
LVDS_TB_P: R67.1, X3.19; also elsewhere on the board
LVDS_TCLK_N: R69.2, X3.14; also elsewhere on the board
LVDS_TCLK_P: R69.1, X3.13; also elsewhere on the board
LVDS_TC_N: R68.2, X3.17; also elsewhere on the board
LVDS_TC_P: R68.1, X3.16; also elsewhere on the board
LVDS_TD_N: R70.2, X3.11; also elsewhere on the board
LVDS_TD_P: R70.1, X3.10; also elsewhere on the board
unnamed: J10.P$22 (Y0), R46.2
unnamed: J10.P$20 (Y1), R47.2
unnamed: J10.P$18 (Y2), R48.2
unnamed: J10.P$16 (Y3), R49.2
unnamed: J10.P$14 (Y4), R50.2
unnamed: J10.P$12 (Y5), R51.2
unnamed: J10.P$10 (Y6), R52.2
unnamed: J10.P$8 (Y7), R53.2
unnamed: J10.P$21 (PCLK), R63.2
unnamed: C46.2, J10.P$17 (MCLK), R64.2
unnamed: C47.1, C48.1, C49.1, FB6.1, FB7.1, X3.28, X3.29
unnamed: C50.1, FB8.2, U9.3 (VCC)
SYS_RST: ESD5.2, R58.1, S1.2 (S); also elsewhere on the board
TWI1-SCK: J10.P$6 (SCL), R57.2; also elsewhere on the board
TWI1-SDA: J10.P$4 (SDA), R56.2; also elsewhere on the board
UBOOT: ESD6.2, R59.1, S2.2 (S); also elsewhere on the board
VCC_3V: C51.1, FB7.2, FB8.1, R58.2, R59.2, R60.2, R61.2, R62.2, R65.1; also elsewhere on the board
