pcduino/pcDuino3C_carrierboard/pcDuino3c_carrierboard_designfiles/pcDuino3c_MB.brd

## EAGLE design pcDuino3c_carrierboard_designfiles/pcDuino3c_MB.brd (continued)

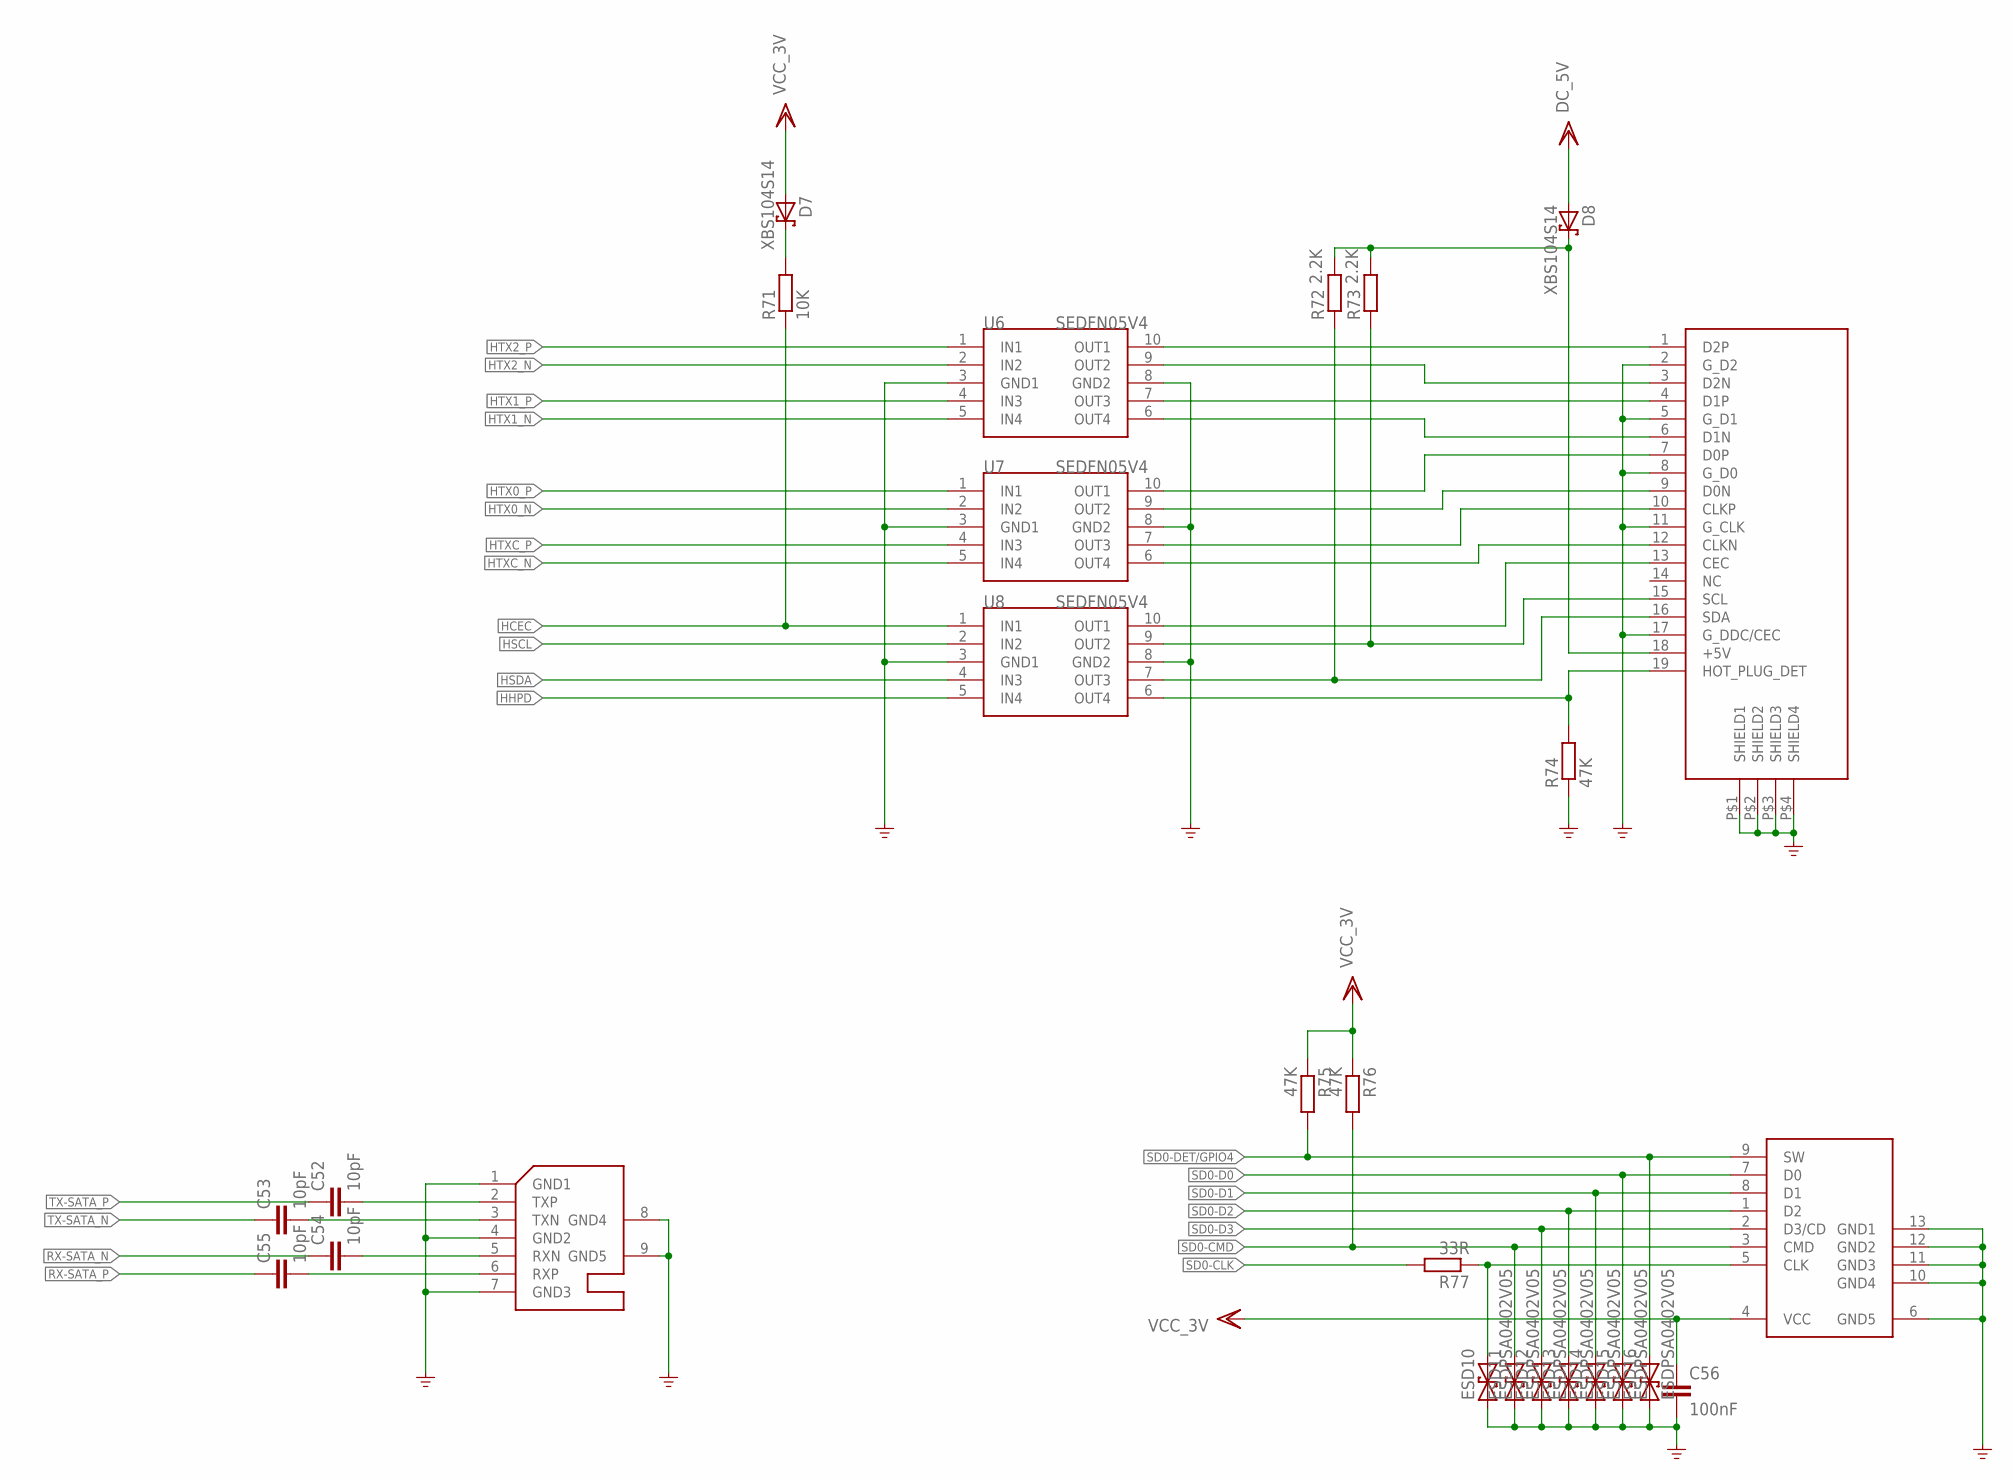
[picture p6: schematic pcDuino3c_MB.sch, sheet 6, HDMIN & SD & SATA]

Parts:
C52, C53, C54, C55: 10pF; C0402K
C56: 100nF; C0402K
D7, D8: XBS104S14; D1206
ESD10, ESD11, ESD12, ESD13, ESD14, ESD15, ESD16: ESDPSA0402V05; R0402
J11: CON-HDMI
J12: SOCKET-MICROSD
J13: CON-SATA
R71: 10K; R0402
R72, R73: 2.2K; R0402
R74, R75, R76: 47K; R0402
R77: 33R; R0402
U6, U7, U8: SEDFN05V4; RCLAMP0524P_1PRIMARY

Connections:
DC_5V: D8.+ (A); also elsewhere on the board
GND: C56.1, ESD10.1, ESD11.1, ESD12.1, ESD13.1, ESD14.1, ESD15.1, ESD16.1, J11.2 (G_D2), J11.5 (G_D1), J11.8 (G_D0), J11.11 (G_CLK), J11.17 (G_DDC/CEC), J11.P$1 (SHIELD1), J11.P$2 (SHIELD2), J11.P$3 (SHIELD3), J11.P$4 (SHIELD4), J12.6 (GND5), J12.10 (GND4), J12.11 (GND3), J12.12 (GND2), J12.13 (GND1), J13.1 (GND1), J13.4 (GND2), J13.7 (GND3), J13.8 (GND4), J13.9 (GND5), R74.1, U6.3 (GND1), U6.8 (GND2), U7.3 (GND1), U7.8 (GND2), U8.3 (GND1), U8.8 (GND2); also elsewhere on the board
HCEC: J11.13 (CEC), R71.1, U8.1 (IN1), U8.10 (OUT1); also elsewhere on the board
HHPD: J11.19 (HOT_PLUG_DET), R74.2, U8.5 (IN4), U8.6 (OUT4); also elsewhere on the board
HSCL: J11.15 (SCL), R73.1, U8.2 (IN2), U8.9 (OUT2); also elsewhere on the board
HSDA: J11.16 (SDA), R72.1, U8.4 (IN3), U8.7 (OUT3); also elsewhere on the board
HTX0_N: J11.9 (D0N), U7.2 (IN2), U7.9 (OUT2); also elsewhere on the board
HTX0_P: J11.7 (D0P), U7.1 (IN1), U7.10 (OUT1); also elsewhere on the board
HTX1_N: J11.6 (D1N), U6.5 (IN4), U6.6 (OUT4); also elsewhere on the board
HTX1_P: J11.4 (D1P), U6.4 (IN3), U6.7 (OUT3); also elsewhere on the board
HTX2_N: J11.3 (D2N), U6.2 (IN2), U6.9 (OUT2); also elsewhere on the board
HTX2_P: J11.1 (D2P), U6.1 (IN1), U6.10 (OUT1); also elsewhere on the board
HTXC_N: J11.12 (CLKN), U7.5 (IN4), U7.6 (OUT4); also elsewhere on the board
HTXC_P: J11.10 (CLKP), U7.4 (IN3), U7.7 (OUT3); also elsewhere on the board
unnamed: D8.- (C), J11.18 (+5V), R72.2, R73.2
unnamed: D7.- (C), R71.2
unnamed: C52.2, J13.2 (TXP)
unnamed: C53.2, J13.3 (TXN)
unnamed: C54.2, J13.5 (RXN)
unnamed: C55.2, J13.6 (RXP)
unnamed: ESD10.2, J12.5 (CLK), R77.1
RX-SATA_N: C54.1; also elsewhere on the board
RX-SATA_P: C55.1; also elsewhere on the board
SD0-CLK: R77.2; also elsewhere on the board
SD0-CMD: ESD11.2, J12.3 (CMD), R76.2; also elsewhere on the board
SD0-D0: ESD15.2, J12.7 (D0); also elsewhere on the board
SD0-D1: ESD14.2, J12.8 (D1); also elsewhere on the board
SD0-D2: ESD13.2, J12.1 (D2); also elsewhere on the board
SD0-D3: ESD12.2, J12.2 (D3/CD); also elsewhere on the board
SD0-DET/GPIO4: ESD16.2, J12.9 (SW), R75.2; also elsewhere on the board
TX-SATA_N: C53.1; also elsewhere on the board
TX-SATA_P: C52.1; also elsewhere on the board
VCC_3V: C56.2, D7.+ (A), J12.4 (VCC), R75.1, R76.1; also elsewhere on the board

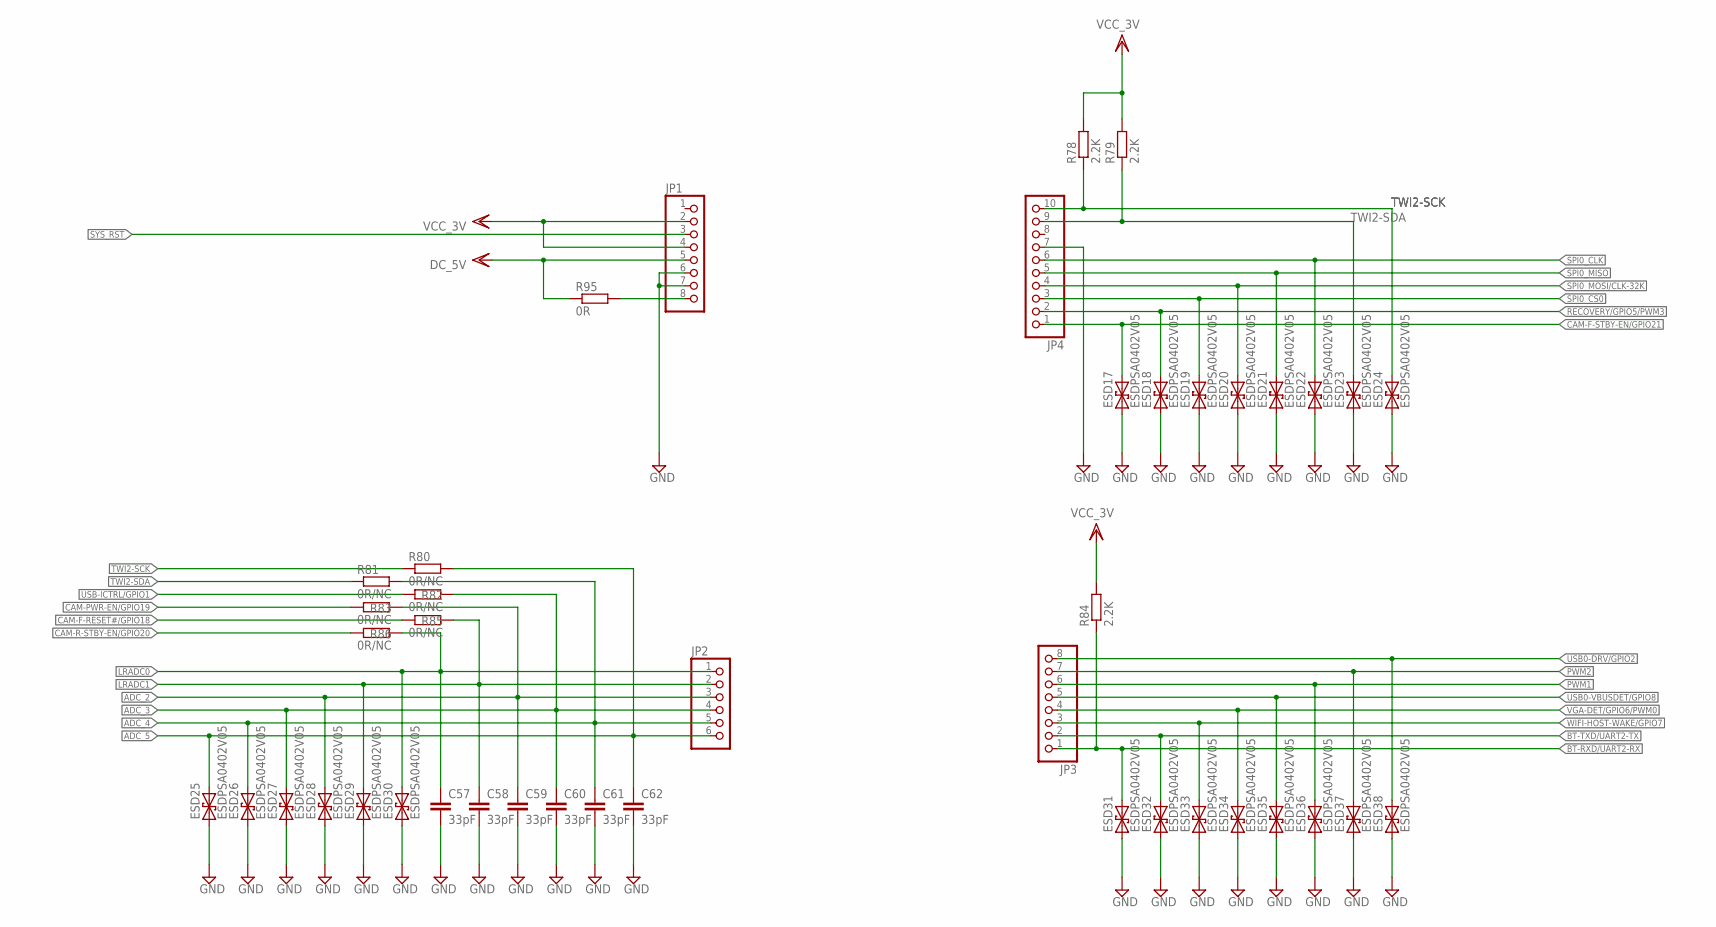
[picture p7: schematic pcDuino3c_MB.sch, sheet 7, Arduino]

Parts:
C57, C58, C59, C60, C61, C62: 33pF; C0402K
ESD17, ESD18, ESD19, ESD20, ESD21, ESD22, ESD23, ESD24, ESD25, ESD26, ESD27, ESD28, ESD29, ESD30, ESD31, ESD32, ESD33, ESD34, ESD35, ESD36, ESD37, ESD38: ESDPSA0402V05; R0402
JP1, JP3: PINHD-1X8; 1X08
JP2: PINHD-1X6; 1X06
JP4: PINHD-1X10; 1X10
R78, R79, R84: 2.2K; R0402
R80, R81, R82, R83, R85, R86: 0R/NC; R0402
R95: 0R; R0805

Connections:
ADC_2: C59.1, ESD28.2, JP2.3, R83.2; also elsewhere on the board
ADC_3: C60.1, ESD27.2, JP2.4, R82.2; also elsewhere on the board
ADC_4: C61.1, ESD26.2, JP2.5, R81.2; also elsewhere on the board
ADC_5: C62.1, ESD25.2, JP2.6, R80.2; also elsewhere on the board
BT-RXD/UART2-RX: ESD31.2, JP3.1, R84.1; also elsewhere on the board
BT-TXD/UART2-TX: ESD32.2, JP3.2; also elsewhere on the board
CAM-F-RESET#/GPIO18: R85.1; also elsewhere on the board
CAM-F-STBY-EN/GPIO21: ESD17.2, JP4.1; also elsewhere on the board
CAM-PWR-EN/GPIO19: R83.1; also elsewhere on the board
CAM-R-STBY-EN/GPIO20: R86.1; also elsewhere on the board
DC_5V: JP1.5, R95.1; also elsewhere on the board
GND: C57.2, C58.2, C59.2, C60.2, C61.2, C62.2, ESD17.1, ESD18.1, ESD19.1, ESD20.1, ESD21.1, ESD22.1, ESD23.1, ESD24.1, ESD25.1, ESD26.1, ESD27.1, ESD28.1, ESD29.1, ESD30.1, ESD31.1, ESD32.1, ESD33.1, ESD34.1, ESD35.1, ESD36.1, ESD37.1, ESD38.1, JP1.6, JP1.7, JP4.7; also elsewhere on the board
LRADC0: C57.1, ESD30.2, JP2.1, R86.2; also elsewhere on the board
LRADC1: C58.1, ESD29.2, JP2.2, R85.2; also elsewhere on the board
unnamed: JP1.8, R95.2
PWM1: ESD36.2, JP3.6; also elsewhere on the board
PWM2: ESD37.2, JP3.7; also elsewhere on the board
RECOVERY/GPIO5/PWM3: ESD18.2, JP4.2; also elsewhere on the board
SPI0_CLK: ESD22.2, JP4.6; also elsewhere on the board
SPI0_CS0: ESD19.2, JP4.3; also elsewhere on the board
SPI0_MISO: ESD21.2, JP4.5; also elsewhere on the board
SPI0_MOSI/CLK-32K: ESD20.2, JP4.4; also elsewhere on the board
SYS_RST: JP1.3; also elsewhere on the board
TWI2-SCK: ESD24.2, JP4.10, R78.1, R80.1; also elsewhere on the board
TWI2-SDA: ESD23.2, JP4.9, R79.1, R81.1; also elsewhere on the board
USB0-DRV/GPIO2: ESD38.2, JP3.8; also elsewhere on the board
USB0-VBUSDET/GPIO8: ESD35.2, JP3.5; also elsewhere on the board
USB-ICTRL/GPIO1: R82.1; also elsewhere on the board
VCC_3V: JP1.2, JP1.4, R78.2, R79.2, R84.2; also elsewhere on the board
VGA-DET/GPIO6/PWM0: ESD34.2, JP3.4; also elsewhere on the board
WIFI-HOST-WAKE/GPIO7: ESD33.2, JP3.3; also elsewhere on the board

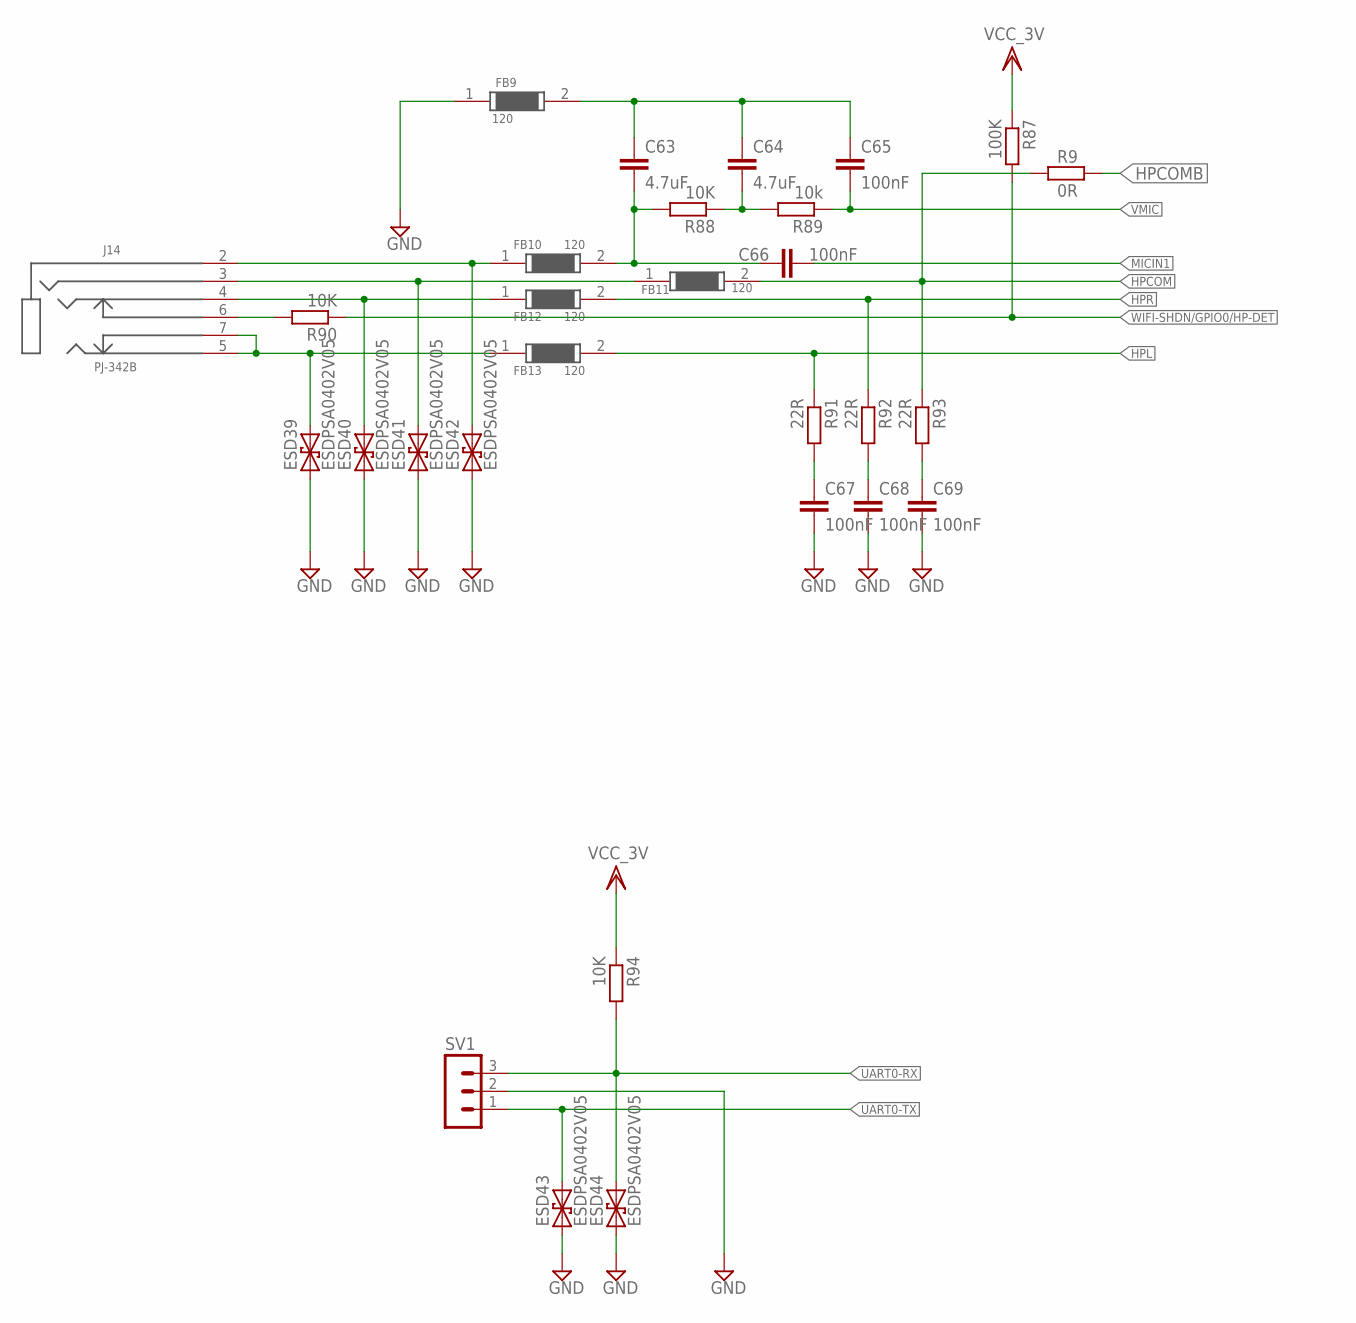
[picture p8: schematic pcDuino3c_MB.sch, sheet 8, Audio & DBG]

Parts:
C63, C64: 4.7uF; C0402K
C65, C66, C67, C68, C69: 100nF; C0402K
ESD39, ESD40, ESD41, ESD42, ESD43, ESD44: ESDPSA0402V05; R0402
FB9, FB10, FB11, FB12, FB13: 120; R0603
J14: PJ-342B
R9: 0R; R0402
R87: 100K; R0402
R88, R90, R94: 10K; R0402
R89: 10k; R0402
R91, R92, R93: 22R; R0402
SV1: MA03-1

Connections:
GND: C67.2, C68.2, C69.2, ESD39.1, ESD40.1, ESD41.1, ESD42.1, ESD43.1, ESD44.1, FB9.1, SV1.2; also elsewhere on the board
HPCOM: FB11.2, R9.1, R93.1; also elsewhere on the board
HPCOMB: R9.2; also elsewhere on the board
HPL: FB13.2, R91.1; also elsewhere on the board
HPR: FB12.2, R92.1; also elsewhere on the board
MICIN1: C66.2; also elsewhere on the board
unnamed: ESD41.2, FB11.1, J14.3
unnamed: ESD40.2, FB12.1, J14.4
unnamed: ESD42.2, FB10.1, J14.2
unnamed: ESD39.2, FB13.1, J14.5, J14.7
unnamed: C67.1, R91.2
unnamed: C68.1, R92.2
unnamed: C69.1, R93.2
unnamed: C63.2, C66.1, FB10.2, R88.2
unnamed: C64.2, R88.1, R89.2
unnamed: C63.1, C64.1, C65.1, FB9.2
unnamed: J14.6, R90.2
UART0-RX: ESD44.2, R94.2, SV1.3; also elsewhere on the board
UART0-TX: ESD43.2, SV1.1; also elsewhere on the board
VCC_3V: R87.1, R94.1; also elsewhere on the board
VMIC: C65.2, R89.1; also elsewhere on the board
WIFI-SHDN/GPIO0/HP-DET: R87.2, R90.1; also elsewhere on the board

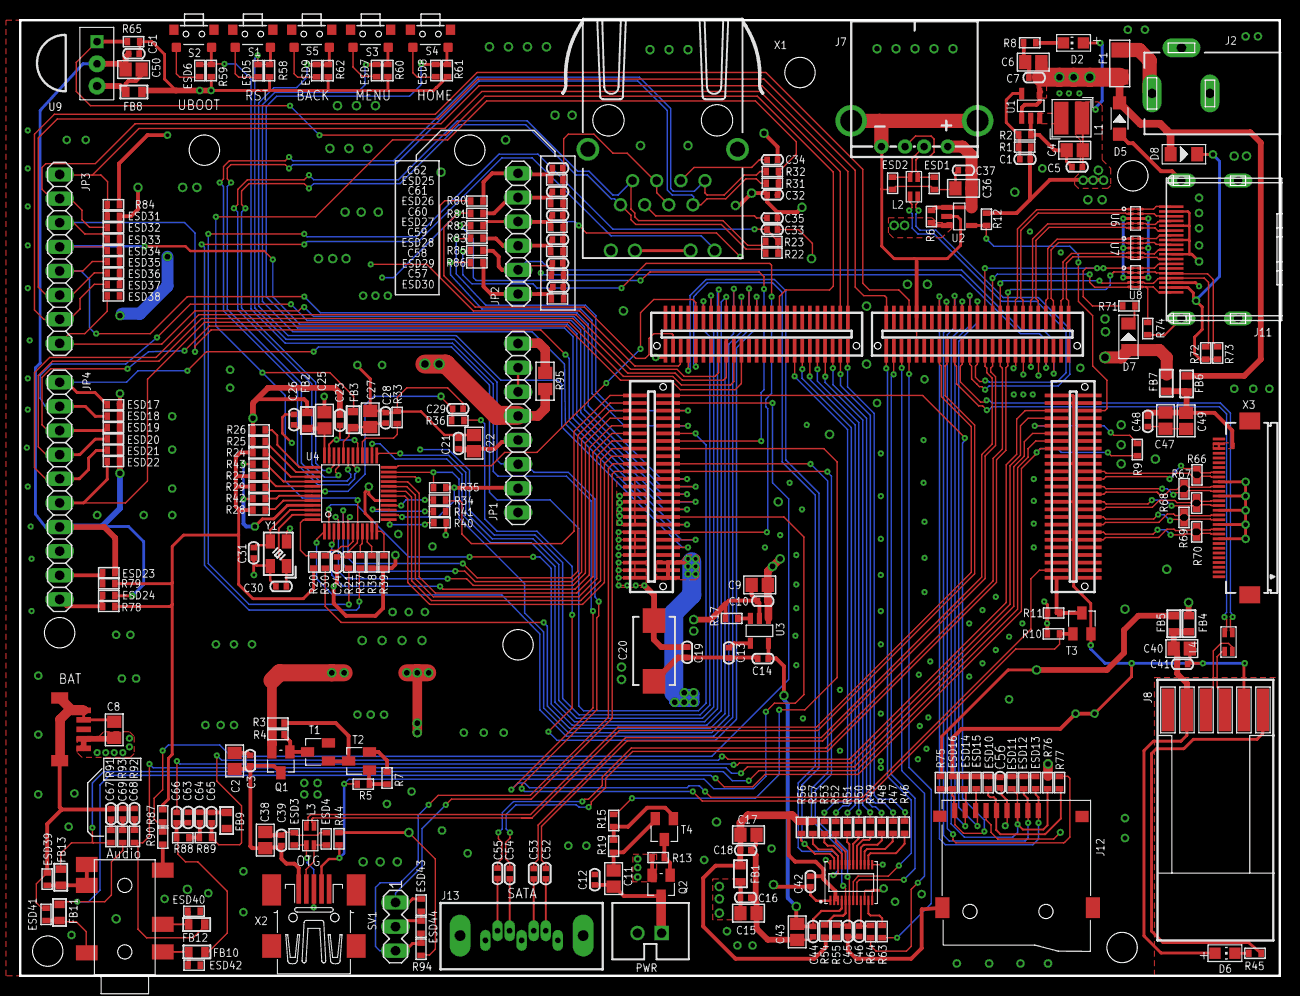
[picture p9: board pcDuino3c_MB.brd from above]

Board: 4 copper layers, 132.6 x 100.6 mm, 270 parts (0 on the bottom side), 209 nets.
